kerasqun/Ebike_BLE_Lock-/README.md

# 两轮电动车 BLE 解锁 — v0.2

## 产品行为
1. 手机(配对并 BIND)靠近到 RSSI > -70 → 进入 **ARMED**(准备)，不立刻通电
2. 准备态下捏刹车 / 轻推车(SW-420 检测到震动) → **2 秒内**吸合继电器通电
3. 人离开约 30 秒 → 自动断电
4. 完全锁车且未在准备态时，短时多次震动 → 蜂鸣器防盗报警
5. iPhone 无感：固件在绑定后订阅 **ANCS**，由 iOS 系统保活蓝牙连接(锁屏/杀 App 不断)

## 接线 (ESP32-C3)
- 5V 降压 → C3 5V / 继电器 VCC / 蜂鸣器 VCC；GND 共地
- GPIO3 → 继电器 IN（默认高电平触发；低电平触发把 `RELAY_ACTIVE` 改成 `LOW`）
- GPIO4 → 有源蜂鸣器
- GPIO5 → SW-420 DO（传感器用 3.3V）

## 编译
Arduino IDE，板子 ESP32C3 Dev Module，USB CDC On Boot 开；库：NimBLE-Arduino 2.x

## 首次配对
1. nRF Connect 连 `EBike-Lock`，允许系统配对
2. 写 `PWD:123456:你的新密码`
3. 写 `BIND:新密码`；iPhone 可能弹「允许通知」→ 允许（这就是 ANCS）
4. 锁屏走远再走回：应自动重连；靠近后短鸣一声(ARMED)，捏刹车应通电

## 首轮实物验收标准
测试前：先用万用表量一下降压模块的输出，确认在 5V 左右，再接上开发板。
两块 C3 板子用同样的方法各测一遍，顺便比较两块板子的天线。

| # | 项目 | 方法 | 通过标准 |
|---|---|---|---|
| 1 | 锁屏后 ANCS 自动重连 | iPhone 锁屏放 10 分钟以上，走远再走回来，重复 20 次 | 成功 ≥ 19 次（95%），记录每次重连耗时 |
| 2 | 靠近后捏刹车通电 | 走到车旁，等提示音（进入准备状态）后捏一下刹车 | 2 秒内继电器吸合 |
| 3 | 隔墙不误开 | 人在墙后或楼上停留 5 分钟以上 | 不进入准备状态，也不开锁；不达标就把 `RSSI_NEAR` 调严 |
| 4 | 离开后断电 | 开锁后走出范围 | 约 30 秒后断电 |
| 5 | 锁车待机电流 | 在电池一侧串电流表测量 | 第一版 ≤ 5mA（停一个月耗电约 17%），下一版目标 ≤ 2mA（约 7%） |
| 6 | 防盗报警 | 锁车、手机不在附近时摇车 | 蜂鸣器报警 |

测试记录建议写在 `docs/test-log.md` 里。

## 已定型号 (助理选型)
- 继电器: 5V 光耦单路, **跳线选高电平触发**, `RELAY_ACTIVE=HIGH`
- 蜂鸣器: KY-012 有源, GPIO 高电平响
- 震动: SW-420
- 降压: 9–120V→5V
- 固件 v0.2.1: 上电先写低再设 OUTPUT, 避免重启误吸合
