kerasqun/Ebike_BLE_Lock-/cad/preview.png

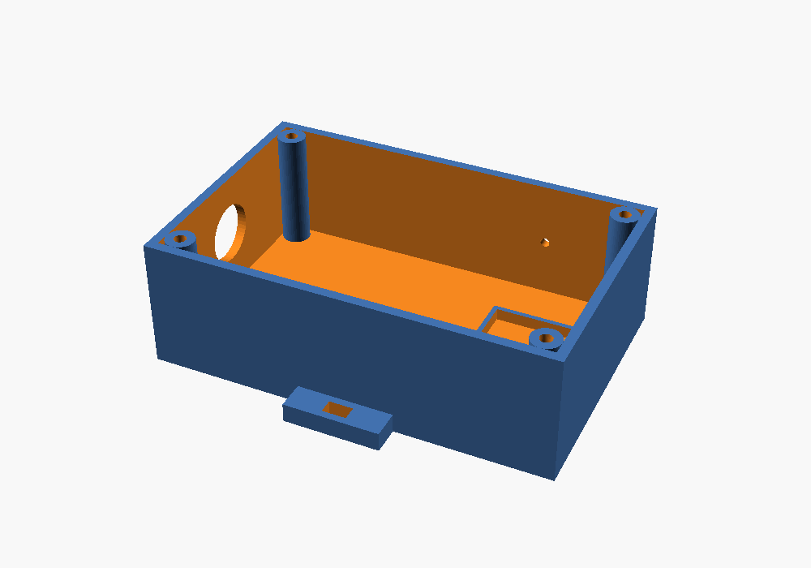
cad/preview.png
