kerasqun/Ebike_BLE_Lock-/cad/lid.stl

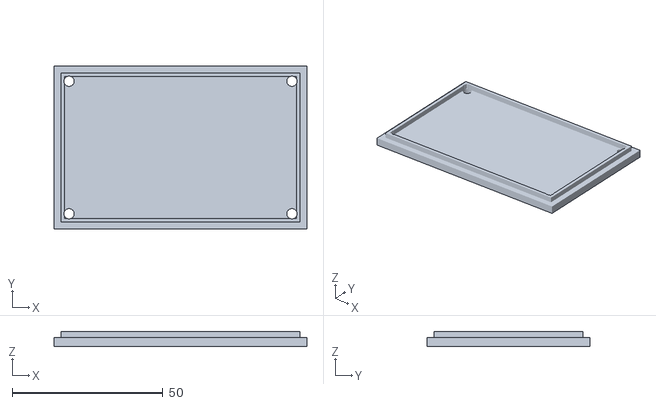
[picture p2: CAD file, 2026-10-14]
cad/lid.stl
84.0 x 54.0 x 5.00
