kerasqun/Ebike_BLE_Lock-/cad/body.stl

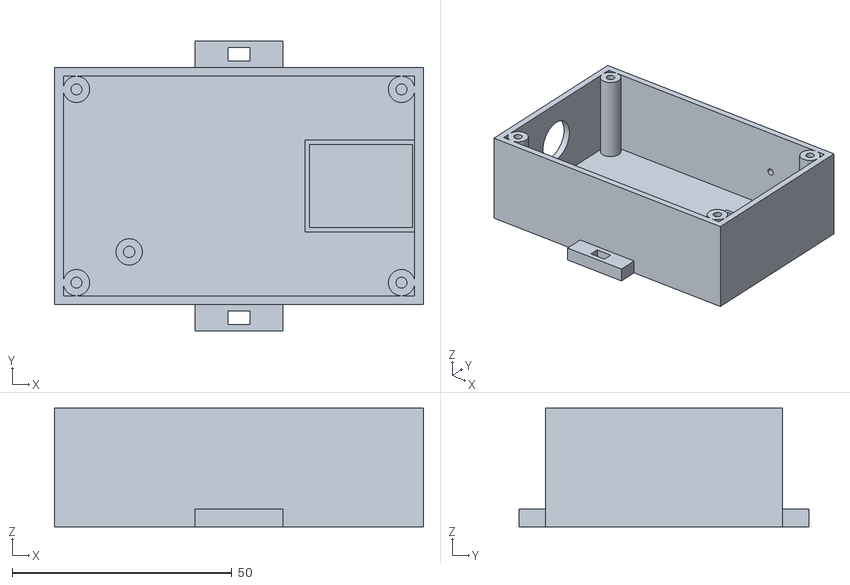
[picture p3: CAD file, 2026-10-14]
cad/body.stl
84.0 x 66.0 x 27.0
