kerasqun/Ebike_BLE_Lock-/(commit log)

2026-10-14 firmware v0.2.1: BLE 解锁 + ANCS 保活 + 靠近准备/震动通电 + 防盗报警
2026-10-14 docs: 首轮实物验收标准
2026-10-14 hw v0.1: 接线说明 docs/wiring.md + 3D 打印外壳 cad/; 待机电流指标改为第一版 5mA
    [body.stl, enclosure.scad, lid.stl]
